albertvaka/MHI-WifiController/presentation_cat.pdf

# Enginyeria inversa d'un aparell d'aire condicionat per connectar-lo al WiFi

Albert Vaca Cintora <albertvaka@gmail.com>

Projecte original: Albert Vaca Cintora, Joan Montserrat, Marce Coll

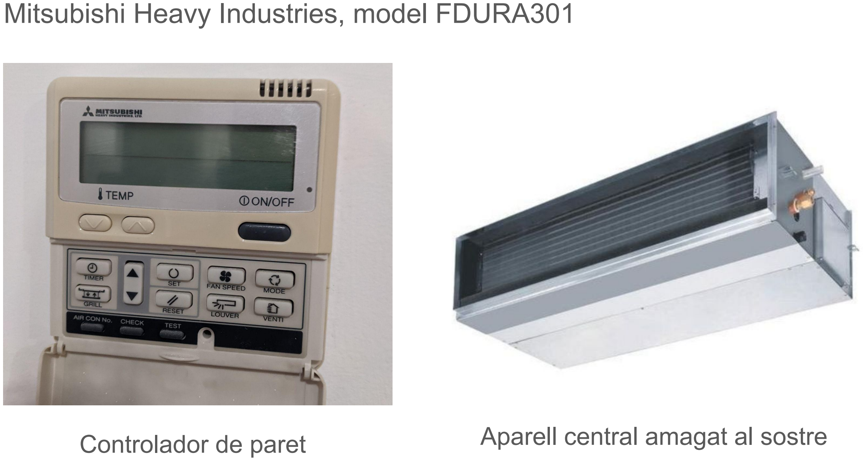
[picture p1: page 2]

Aparell central amagat al sostre

Controlador de paret

Mitsubishi Heavy Industries, model FDURA301

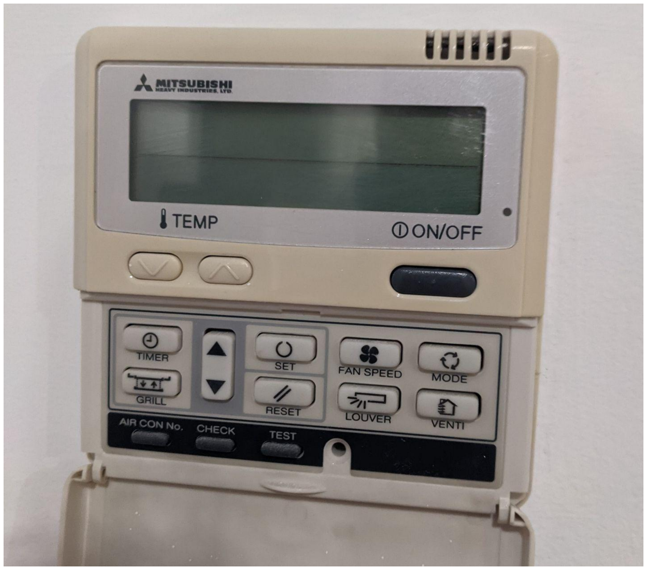
[picture p2: figure]

Per canviar la temperatura m'he d'aixecar del sofà.

L'única automatització possible és configurar l'hora d'encendre/apagar.

Podem fer-ho millor…

Mitsubishi Heavy Industries, model FDURA301

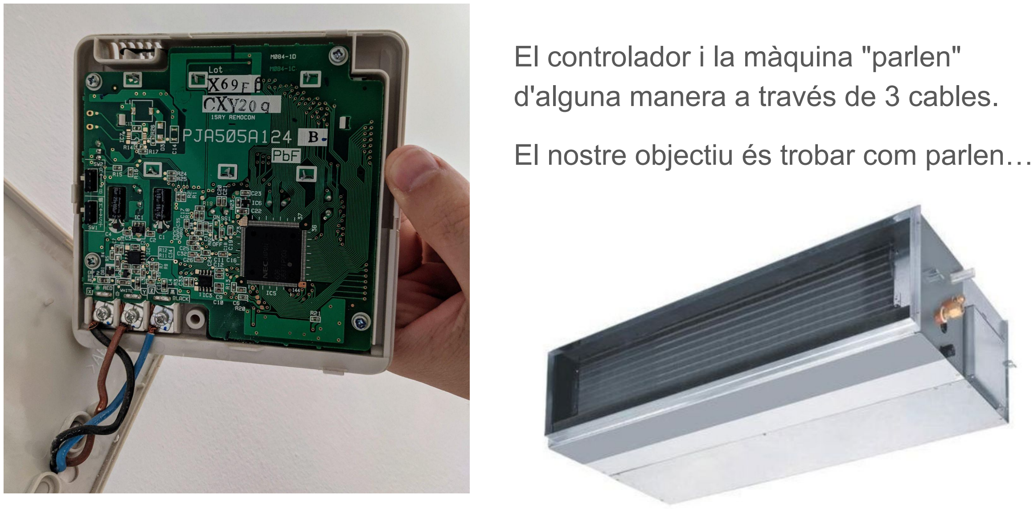
[picture p3: page 4]

El controlador i la màquina "parlen" d'alguna manera a través de 3 cables.

El nostre objectiu és trobar com parlen…

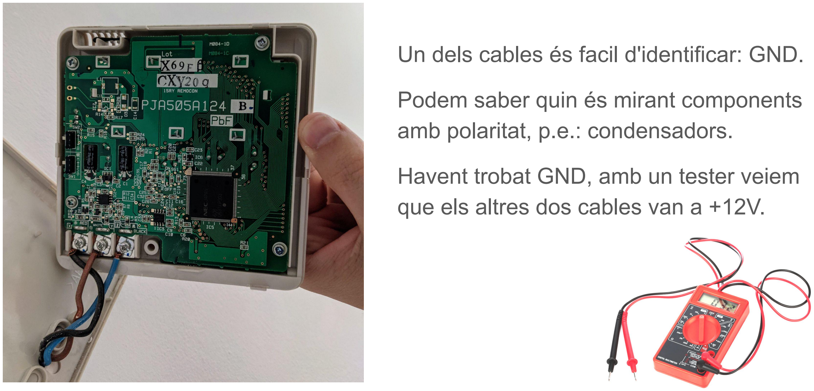
[picture p4: page 5]

Un dels cables és facil d'identificar: GND.

Podem saber quin és mirant components amb polaritat, p.e.: condensadors.

Havent trobat GND, amb un tester veiem que els altres dos cables van a +12V.

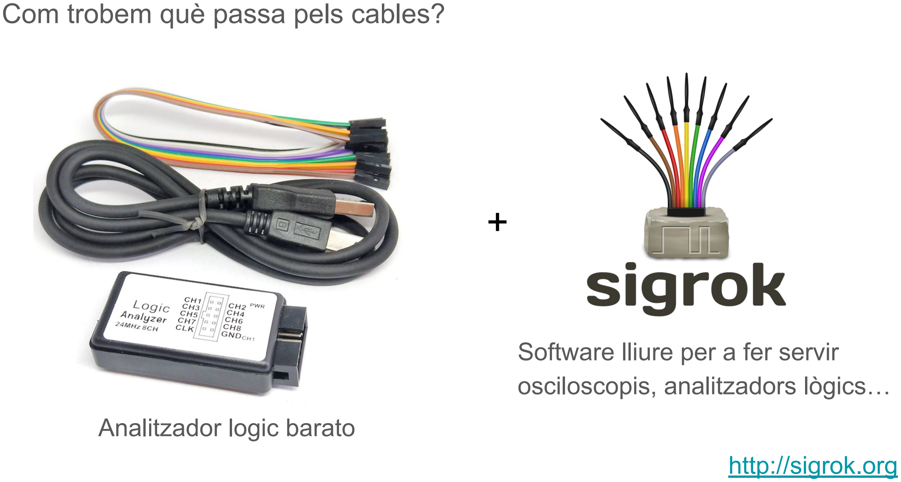
[picture p5: page 6]

Analitzador logic barato

+

Com trobem què passa pels cables?

Software lliure per a fer servir osciloscopis, analitzadors lògics…

http://sigrok.org

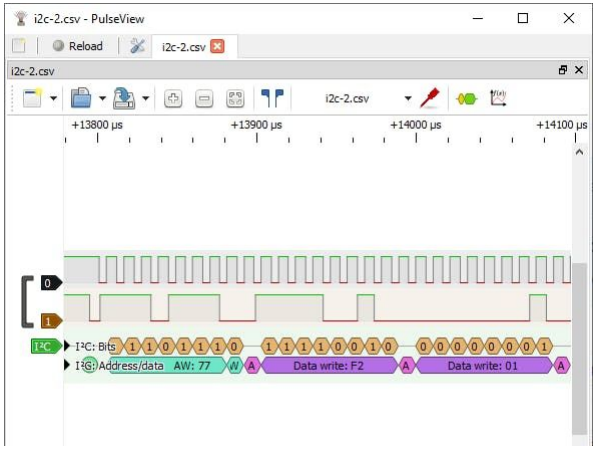
[picture p6: figure]

PulseView, la interfície gràfica de Sigrok

Oju! No podem connectar directament 12V a l'analitzador

El fregiríem.

Oju! No podem connectar directament 12V a l'analitzador

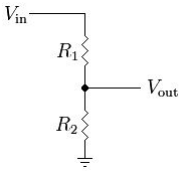
[picture p7: figure]

Esquema i fòrmula d'un
divisor de tensió.

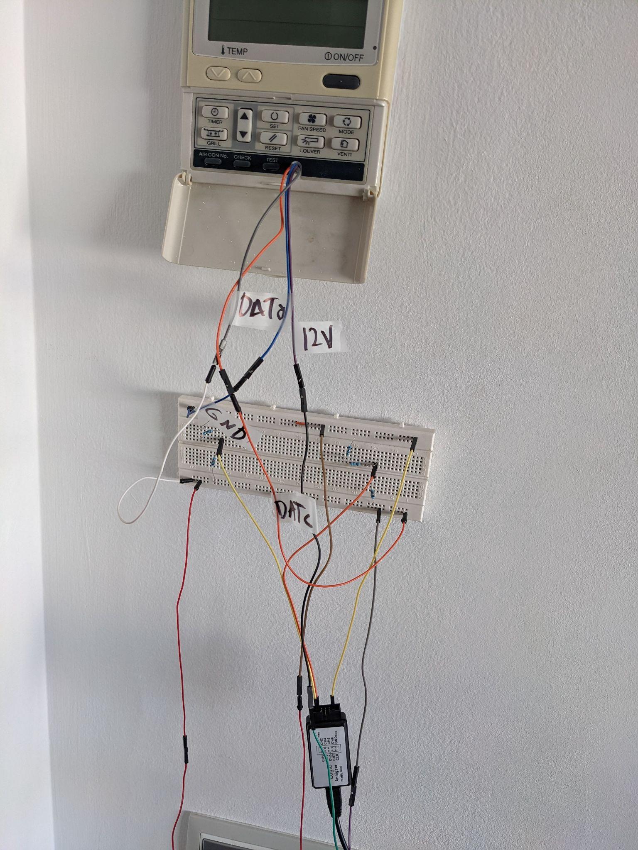
[picture p8: figure]

Dos divisors de tensió entre els dos cables de 12V i l'analitzador.

Els divisors de tensió passen de 12V a ~3V.

El GND també el connectem a l'analitzador, és la referència.

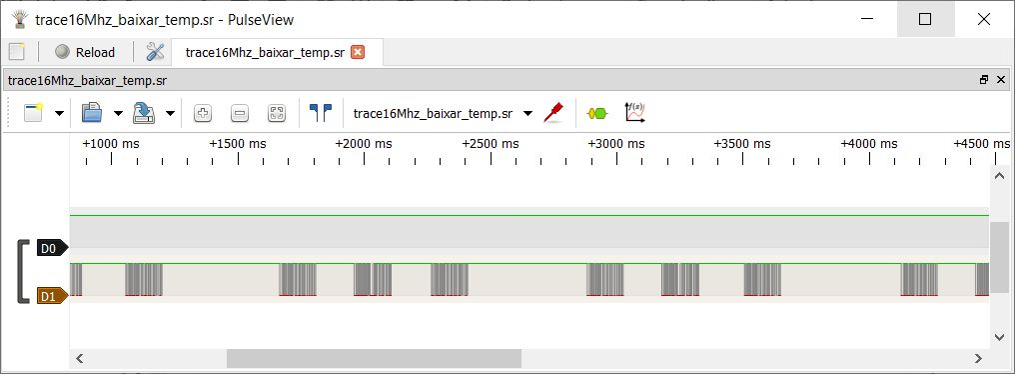
[picture p9: figure]

Veiem cosetes i fem els primers descobriments.

Un dels dos cables de +12V és simplement corrent, no té dades.

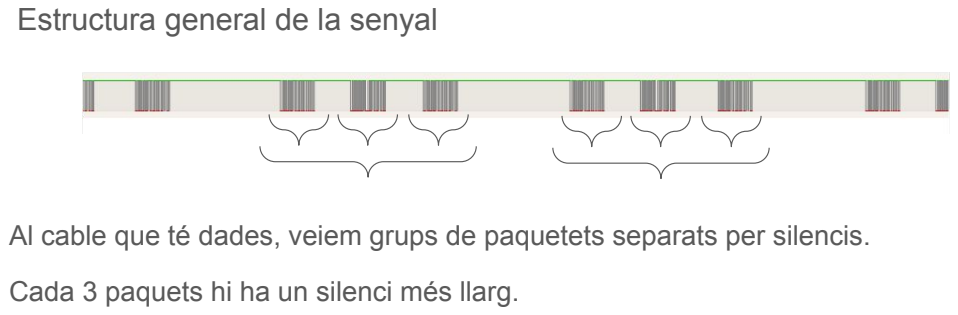
[picture p10: page 13]

Estructura general de la senyal

Al cable que té dades, veiem grups de paquetets separats per silencis.

Cada 3 paquets hi ha un silenci més llarg.

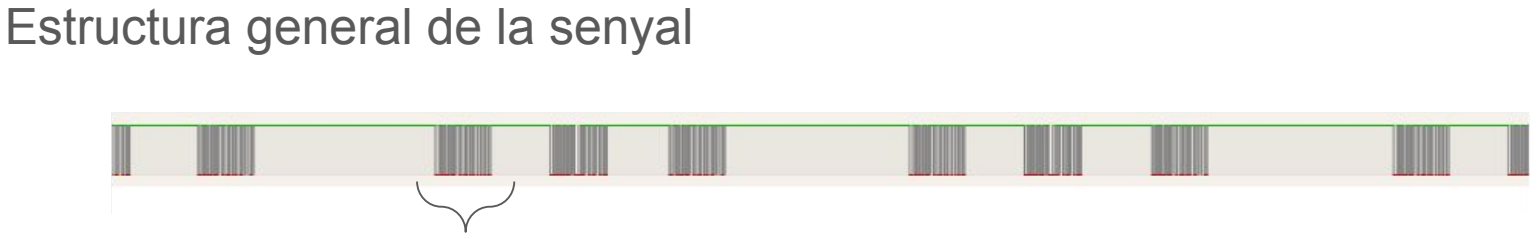
[picture p11: figure]
Estructura general de la senyal

Si fem zoom a un dels paquets, veiem que la senyal és binaria.

S'envien dades tota l'estona, encara que no faci cap canvi al controlador.

També amb l'aire apagat: la senyal d'on/off és digital.

Només hi ha un cable de dades -> la comunicació és unidireccional (??)

Estructura general de la senyal

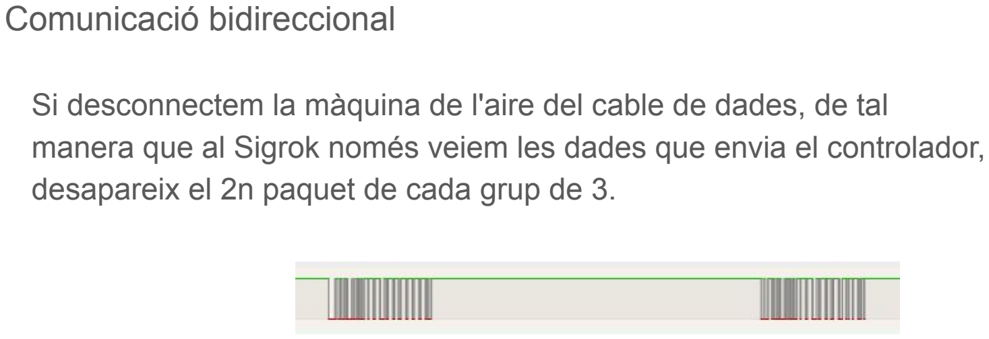
[picture p12: figure]
Comunicació bidireccional

Si desconnectem la màquina de l'aire del cable de dades, de tal manera que al Sigrok només veiem les dades que envia el controlador, desapareix el 2n paquet de cada grup de 3.

Si connectem la màquina però desconnectem el controlador, desapareixen el 1r i el 3r paquets!

Comunicació bidireccional

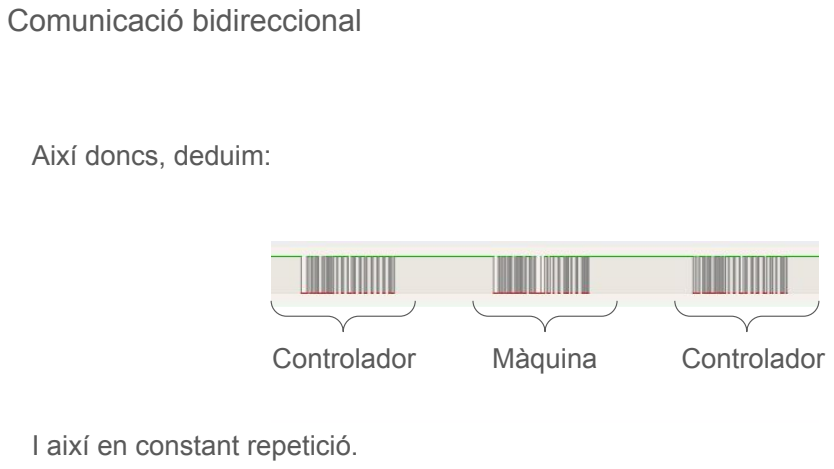
[picture p13: page 18]
Controlador; Màquina; Comunicació bidireccional

Així doncs, deduim:

I així en constant repetició.

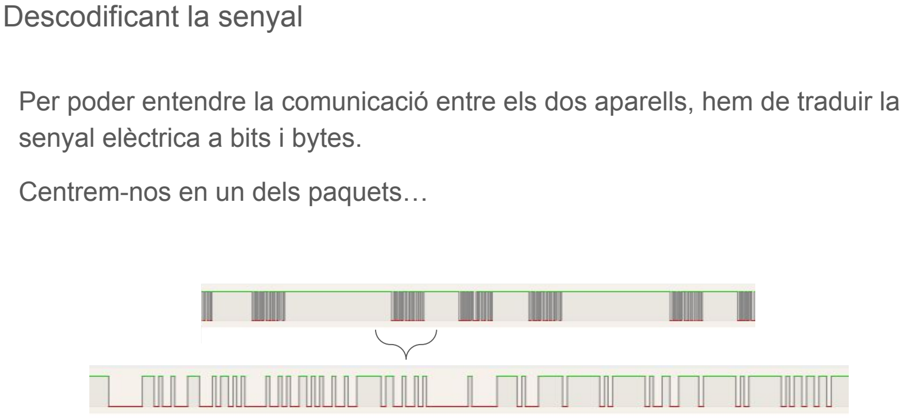
[picture p14: figure]
senyal elèctrica a bits i bytes.; Centrem-nos en un dels paquets…; Descodificant la senyal

Per poder entendre la comunicació entre els dos aparells, hem de traduir la

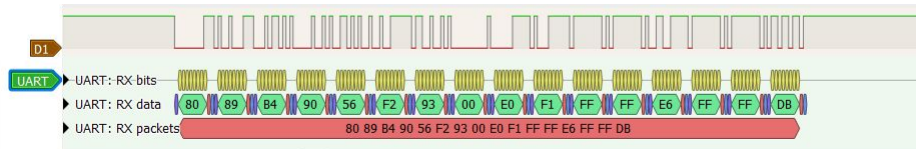
[picture p15: figure]

Tenim sort i el Sigrok sap descodificar el protocol que fan servir:

- UART a 1200 bauds
- Amb bit de paritat senar cada 8 bits
- Agrupats en paquets de 16 bytes

Descodificant la senyal

Així podem descodificar cadascún dels paquets:

Descodificant la senyal

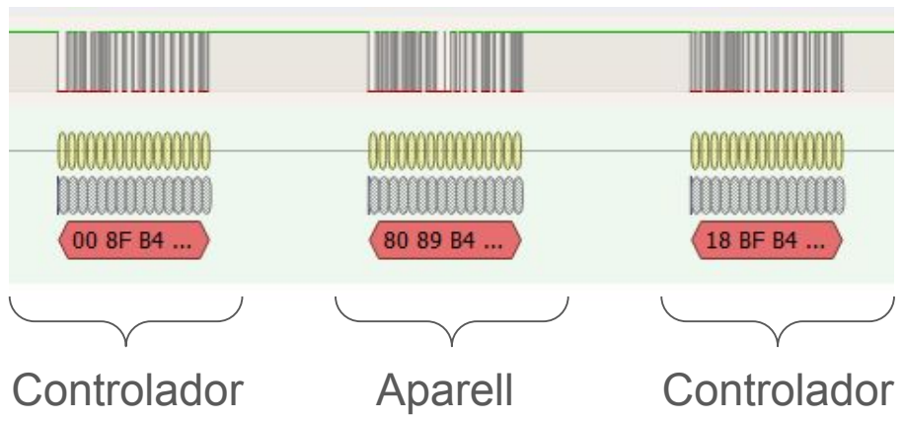
[picture p16: figure]
Controlador; Aparell

Agafem-ne una mostra en format hexadecimal i anem a un editor de text!

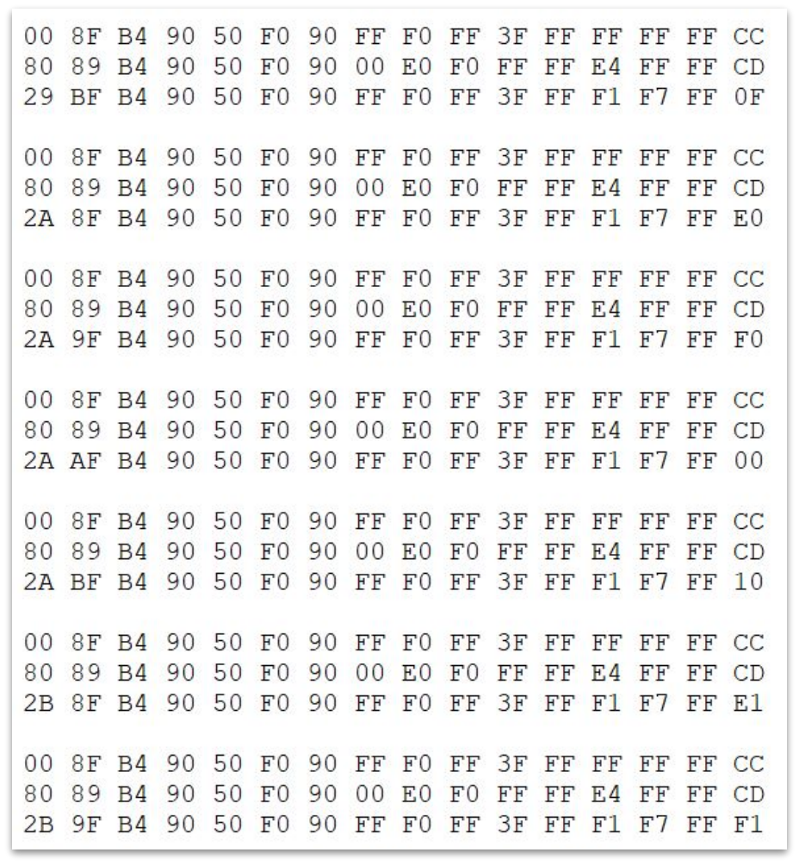
[picture p17: figure]

Si descodifiquem uns quants grups de 3 paquets, veiem que entre un grup i el següent hi ha pocs canvis.

Si descodifiquem uns quants grups de 3 paquets, veiem que entre un grup i el següent hi ha pocs canvis.

Els primers 2 bytes de cada 3r paquet canvien en seqüencia ascendent, segurament són una ID.

Si descodifiquem uns quants grups de 3 paquets, veiem que entre un grup i el següent hi ha pocs canvis.

Els primers 2 bytes de cada 3r paquet canvien en seqüencia ascendent, segurament són una ID.

L'ultim byte té molta més entropia que la resta, segurament és un checksum.

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

Els primers 2 bytes de cada 3r paquet canvien en seqüencia ascendent, segurament són una ID.

L'ultim byte té molta més entropia que la resta, segurament és un checksum.

- En efecte, fent servir eines online que calculen els checksums més comuns veiem que és una suma de bytes módul 256.

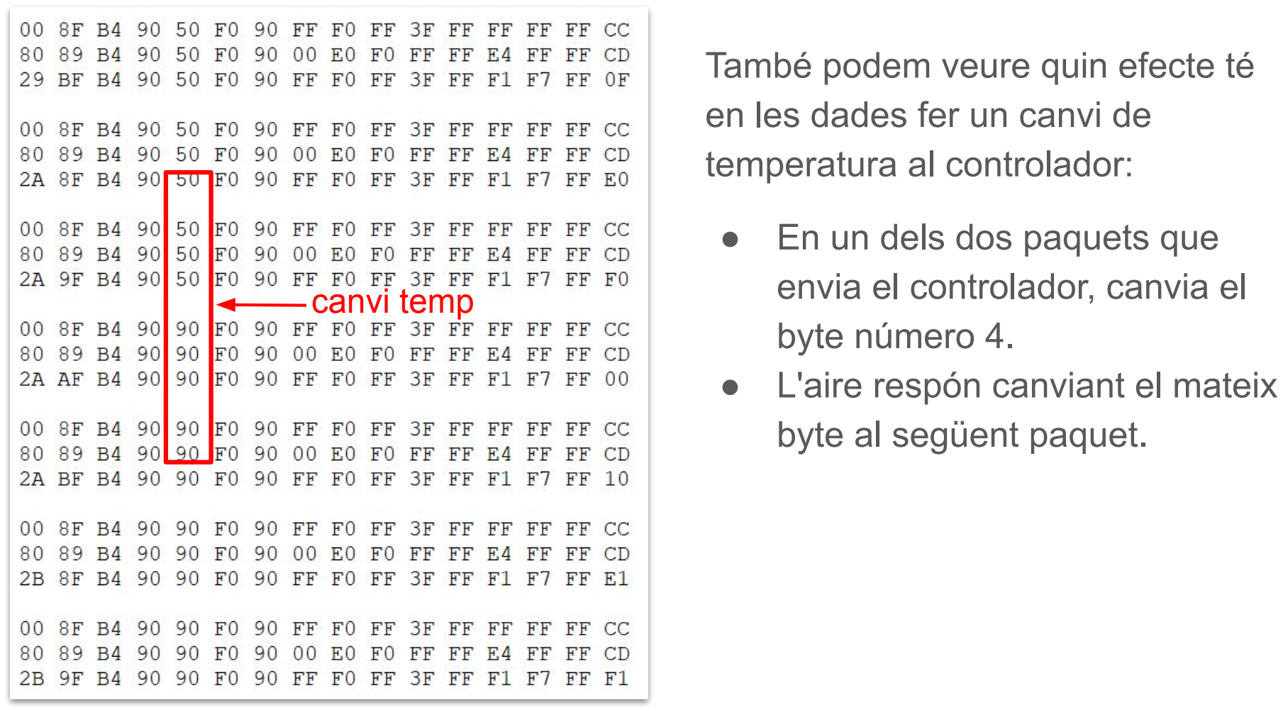
[picture p18: page 27]

També podem veure quin efecte té en les dades fer un canvi de temperatura al controlador:

- En un dels dos paquets que envia el controlador, canvia el byte número 4.
- L'aire respón canviant el mateix byte al següent paquet.

canvi temp

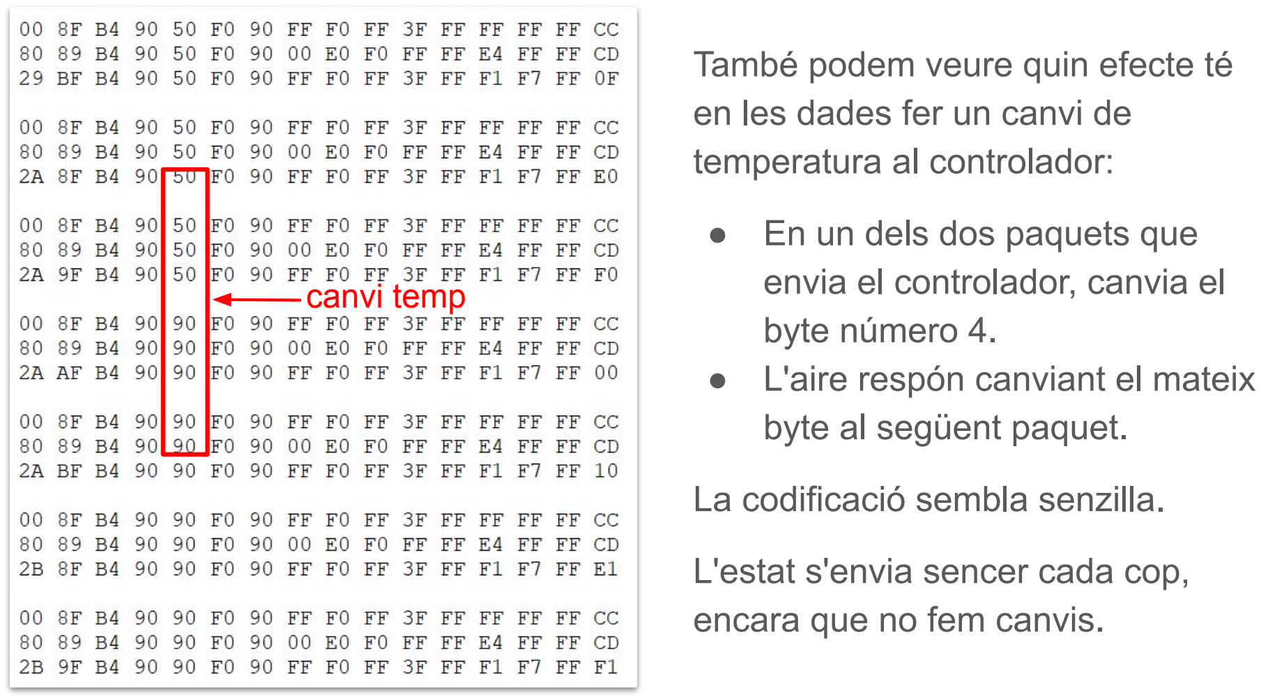
[picture p19: page 28]

També podem veure quin efecte té en les dades fer un canvi de temperatura al controlador:

- En un dels dos paquets que envia el controlador, canvia el byte número 4.
- L'aire respón canviant el mateix byte al següent paquet.

La codificació sembla senzilla.

L'estat s'envia sencer cada cop, encara que no fem canvis.

canvi temp

El Person-in-the-Middle

Si aconseguim modificar aquest estat que el controlador envia, podem donar ordres a la màquina de l'aire.

El Person-in-the-Middle

Si aconseguim modificar aquest estat que el controlador envia, podem donar ordres a la màquina de l'aire.

Si aprofitem que l'estat s'envia constantment i el modifiquem, ens estalviem"inventar" paquets des de zero: partim d'un paquet valid.

- Ens estalviem d'entendre el 100% del paquet, generar les IDs, etc.
- Podem mantenir el controlador de paret i no substituir-lo.

El Person-in-the-Middle

Si aconseguim modificar aquest estat que el controlador envia, podem donar ordres a la màquina de l'aire.

Si aprofitem que l'estat s'envia constantment i el modifiquem, ens estalviem"inventar" paquets des de zero: partim d'un paquet valid.

- Ens estalviem d'entendre el 100% del paquet, generar les IDs, etc.
- Podem mantenir el controlador de paret i no substituir-lo.

El Person-in-the-Middle

Per poder modificar els paquets necessitem intervenir la comunicació.

El Person-in-the-Middle

Per poder modificar els paquets necessitem intervenir la comunicació.

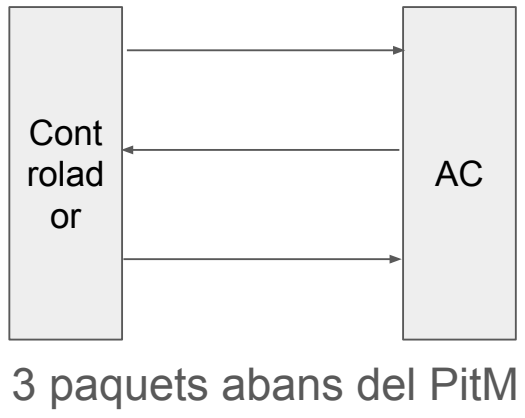
[picture p20: figure]
3 paquets abans del PitM; Cont rolad or

El Person-in-the-Middle

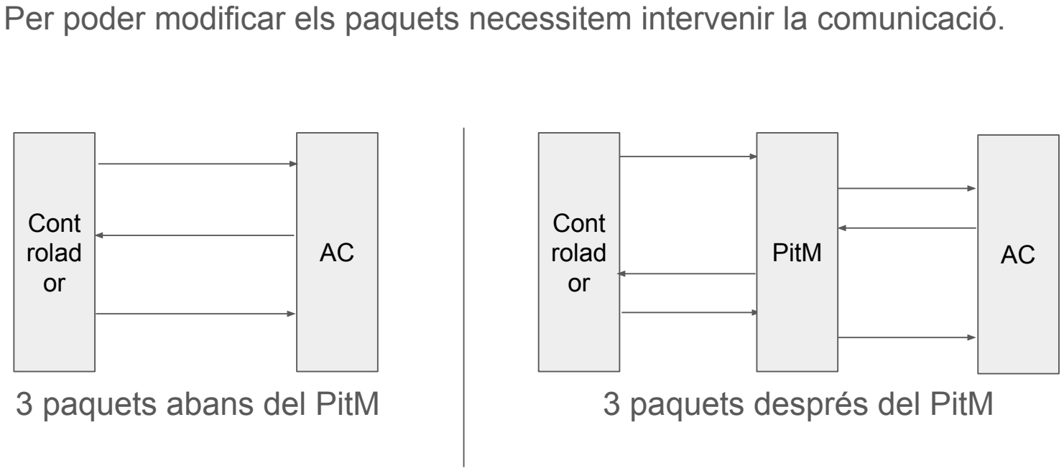
[picture p21: figure]
3 paquets després del PitM; Cont rolad or; PitM; 3 paquets abans del PitM

Per poder modificar els paquets necessitem intervenir la comunicació.

L'Arduino

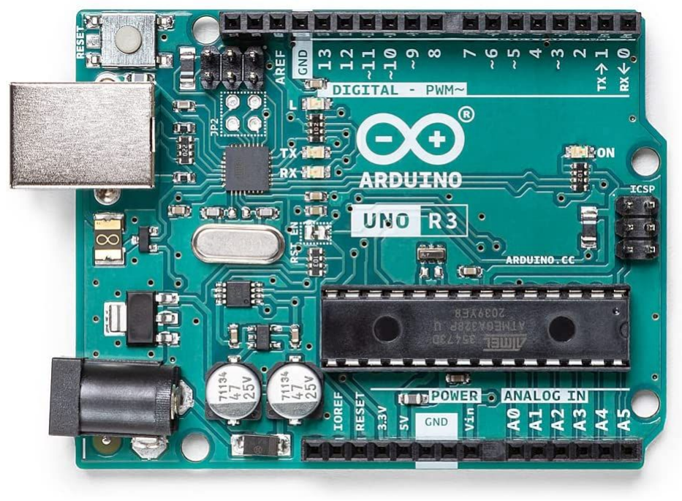
[picture p22: figure]

Projecte de software lliure i hardware lliure.

Fa molt fàcil la interacció entre electrònica i software.

http://ardunio.cc

Problemes de nou amb els 12V

L'arduino "parla" a 5V i no 12V.

El divisor de tensió no és suficient: Necessitem reduir de 12V a 5V per a poder llegir la senyal, però també apujar-la de 5V a 12V quan la enviem.

El "bidirectional logic level converter"

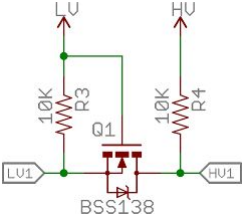
[picture p23: figure]

Internet opina que aquest circuit amb un transistor mosfet i dues resistències fa el que volem.

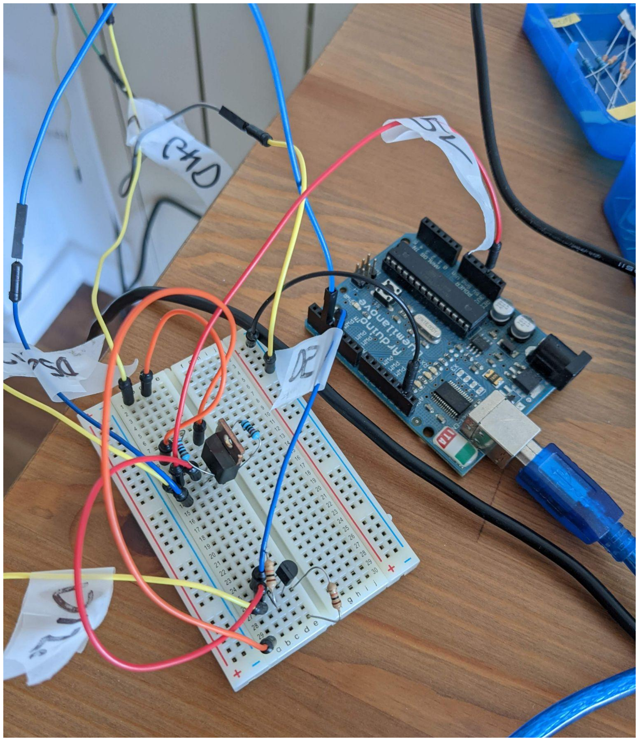
[picture p24: figure]

Arduino i amb dos "bidirectional logic level converters".

Per una banda, connectat a l'aparell de l'aire. Per l'altra, al controlador.

Ja no hi ha un cable de dades directe entre el controlador i la maquina d'aire.

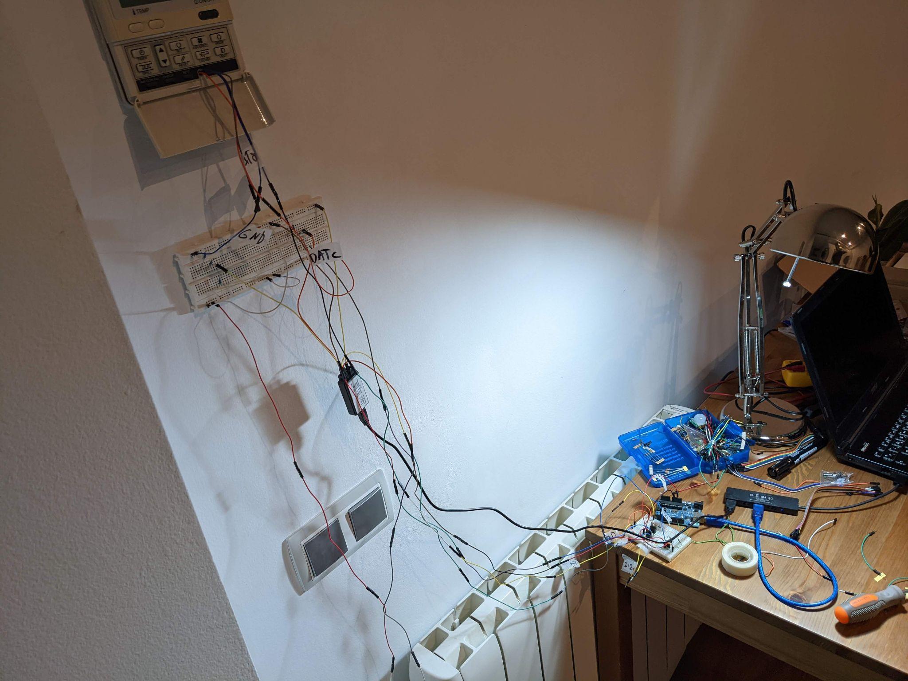
[picture p25: page 39]

Primer objectiu: passar les dades a través nostre i que la màquina i el controlador no s'adonin que som al mig.

A programar

Cont
rolad
or
PitM | AC

Primer objectiu: passar les dades a través nostre i que la màquina i el controlador no s'adonin que som al mig.

Hi ha llibreries d'Arduino per a UART, però no ens seveixen:

- Et fan llegir tot un byte abans de poder-lo escriure
- El delay fa enfadar la maquina d'aire

Cal llegir bit a bit per una banda i escriure'l immediatament per l'altra.

A programar

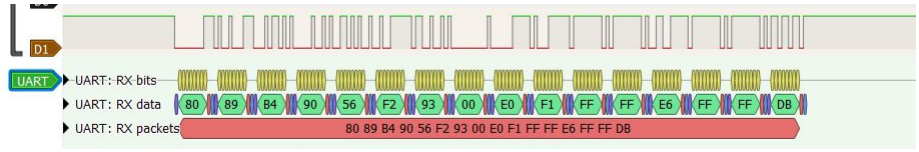
[picture p26: figure]

Primer objectiu: passar les dades a través nostre i que la màquina i el controlador no s'adonin que som al mig.

Hi ha llibreries d'Arduino per a UART, però no ens seveixen:

- Et fan llegir tot un byte abans de poder-lo escriure
- El delay fa enfadar la maquina d'aire

Cal llegir bit a bit per una banda i escriure'l immediatament per l'altra.

~200 linies de codi, i l'aire torna a funcionar!

A programar

https://github.com/albertvaka/MHI-WifiController/blob/69b3c11de/MHI-WifiController.ino

Segon objectiu: modificar l'estat que passa a través nostre.

El bit d'on/off és senzill de trobar i fàcil comprovar si ha canviat.

A programar

Segon objectiu: modificar l'estat que passa a través nostre.

El bit d'on/off és senzill de trobar i fàcil comprovar si ha canviat.

Però ens cal recalcular els parity bits i el checksum!

A programar

Segon objectiu: modificar l'estat que passa a través nostre.

El bit d'on/off és senzill de trobar i fàcil comprovar si ha canviat.

Però ens cal recalcular els parity bits i el checksum!

~260 linies de codi

A programar

https://github.com/albertvaka/MHI-WifiController/blob/e3155bb0c/MHI-WifiController.ino

Tercer objectiu: trobar com es representa la resta de l'estat i poder modificar-lo.

A programar

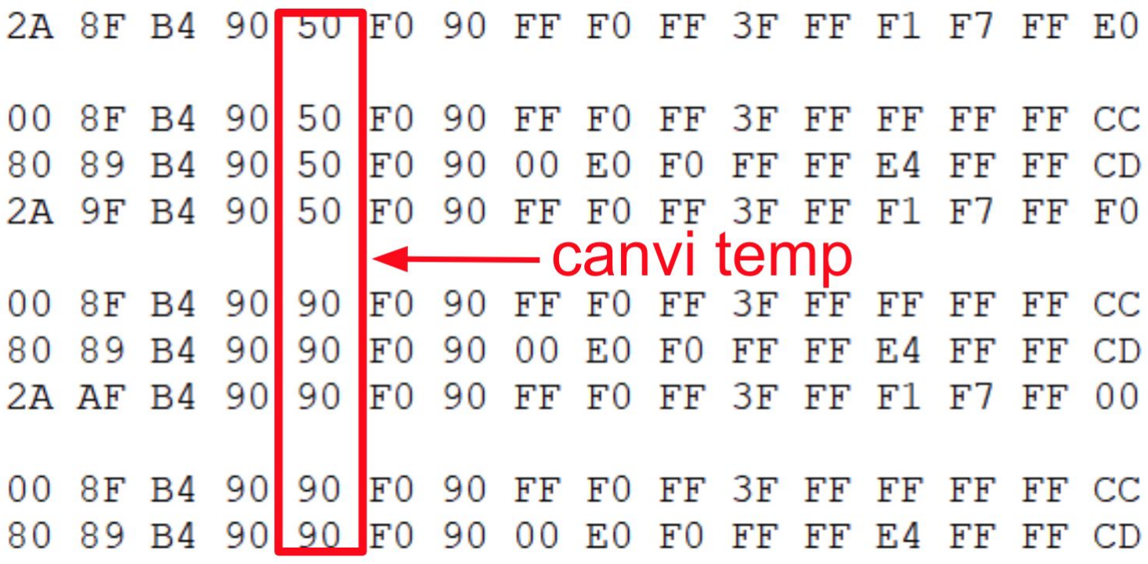
[picture p27: figure]

Tercer objectiu: trobar com es representa la resta de l'estat i poder modificar-lo.

Alguns valors són fàcils: velocitat del ventilador, mode, etc.

Hi ha dues temperatures: la desitjada i la actual. Codificades diferent!

A programar

Tercer objectiu: trobar com es representa la resta de l'estat i poder modificar-lo.

Alguns valors són fàcils: velocitat del ventilador, mode, etc.

Hi ha dues temperatures: la desitjada i la actual. Codificades diferent!

- La temperatura desitjada la podem canviar al valor que vulguem

A programar

Tercer objectiu: trobar com es representa la resta de l'estat i poder modificar-lo.

Alguns valors són fàcils: velocitat del ventilador, mode, etc.

Hi ha dues temperatures: la desitjada i la actual. Codificades diferent!

- La temperatura desitjada la podem canviar al valor que vulguem

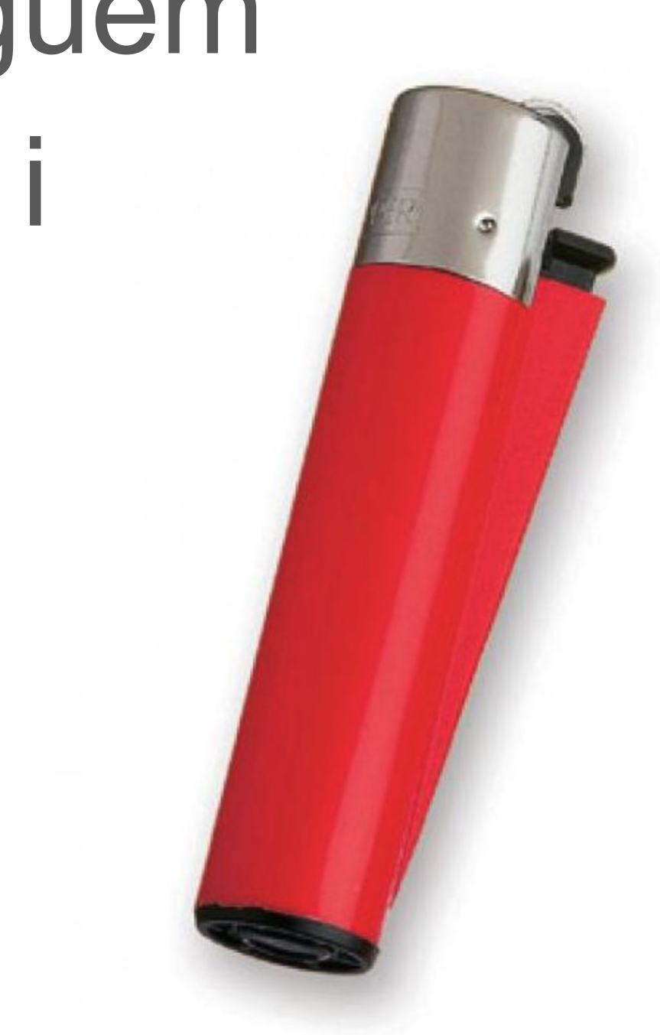
[picture p28: figure]

- La temperatura actual la podem canviar amb un encenedor i mirar el valor.

A programar

Descodificant la temperatura

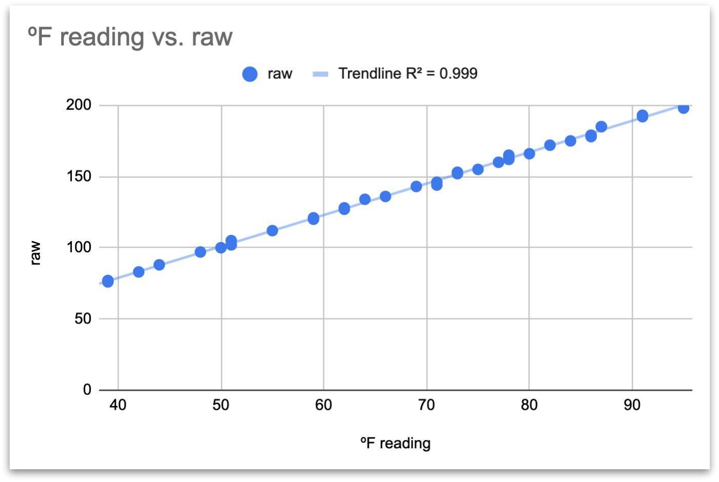
[picture p29: figure]

El controlador no mostra els decimals de la temperatura…Si configurem Fahrenheit tenim salts més petits :)

Resultat:

F = (0.4527 * raw) + 4.353

Amb alguns punts i una regressió lineal podem trobar la fòrmula.

Descodificant la temperatura

F = (0.4527 * raw) + 4.353

És una merda de fòrmula. Algú ha programat això?

Descodificant la temperatura

F = (0.4527 * raw) + 4.353

És una merda de fòrmula. Algú ha programat això?

Passem a Celsius:

C = (0.2515 * raw) - 15.3594

Descodificant la temperatura

F = (0.4527 * raw) + 4.353

És una merda de fòrmula. Algú ha programat això?

Passem a Celsius:

C = (0.2515 * raw) - 15.3594

Ep! Això s'assembla molt a:

C = (0.25 * raw) - 15

Descodificant la temperatura

F = (0.4527 * raw) + 4.353

És una merda de fòrmula. Algú ha programat això?

Passem a Celsius:

C = (0.2515 * raw) - 15.3594

Ep! Això s'assembla molt a:

C = (0.25 * raw) - 15

És molt més raonable que algú hagi programat això!

- Increments de quarts de grau, a partir de -15 graus.

Ja podem llegir i escriure qualsevol part de l'estat!

~350 linies de codi

A programar

https://github.com/albertvaka/MHI-WifiController/blob/c4098a604/MHI-WifiController.ino

Quart objectiu: connectar-ho a internet.

A programar

Quart objectiu: connectar-ho a internet.

Passem d'Arduino a ESP8266 que té WiFi incorporat.

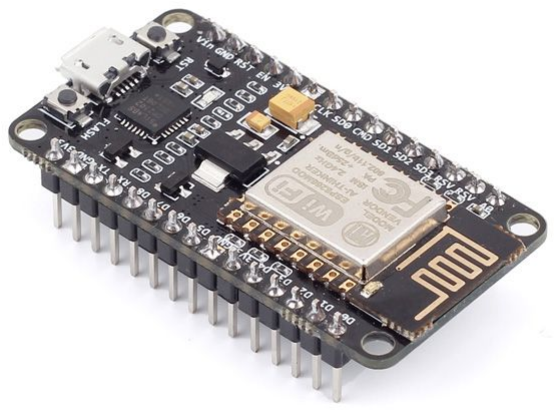
[picture p30: figure]

Pero no és HW lliure :(

A programar

Quart objectiu: connectar-ho a internet.

Passem d'Arduino a ESP8266 que té WiFi incorporat.

Per a interactuar-hi des del mòbil amb una app o via Google Home/Alexa/Siri, hi ha diferents serveis i APIs.

Tampoc son lliures :(

~650 lines de codi

A programar

Prototip funcionant

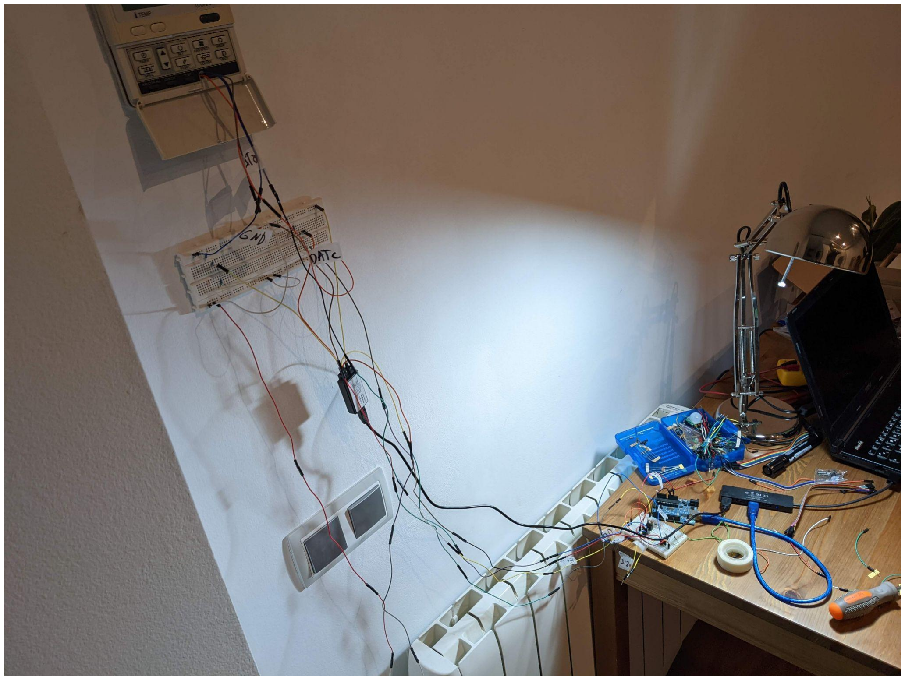
[picture p31: figure]

Pero tenir cables penjant al menjador no mola

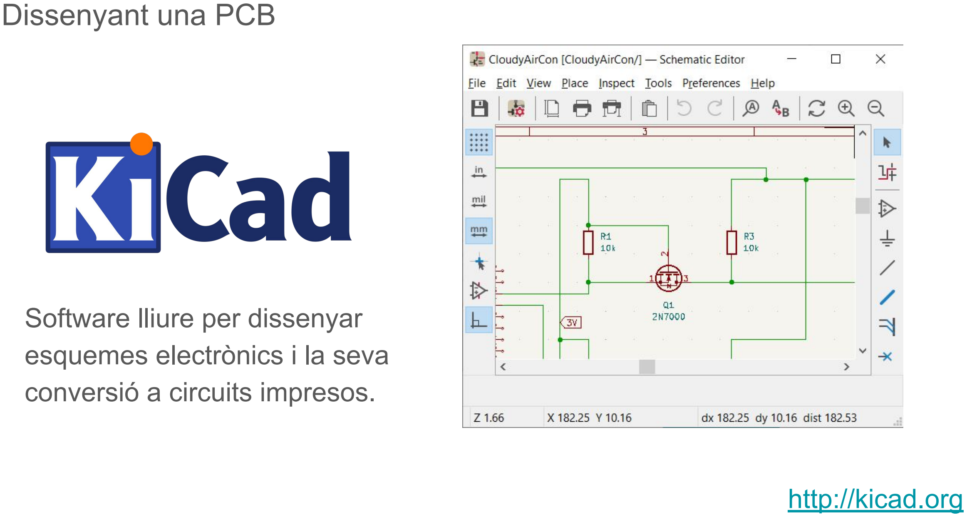
[picture p32: page 60]

Dissenyant una PCB

http://kicad.org (http://sigrok.org)

Software lliure per dissenyar esquemes electrònics i la seva conversió a circuits impresos.

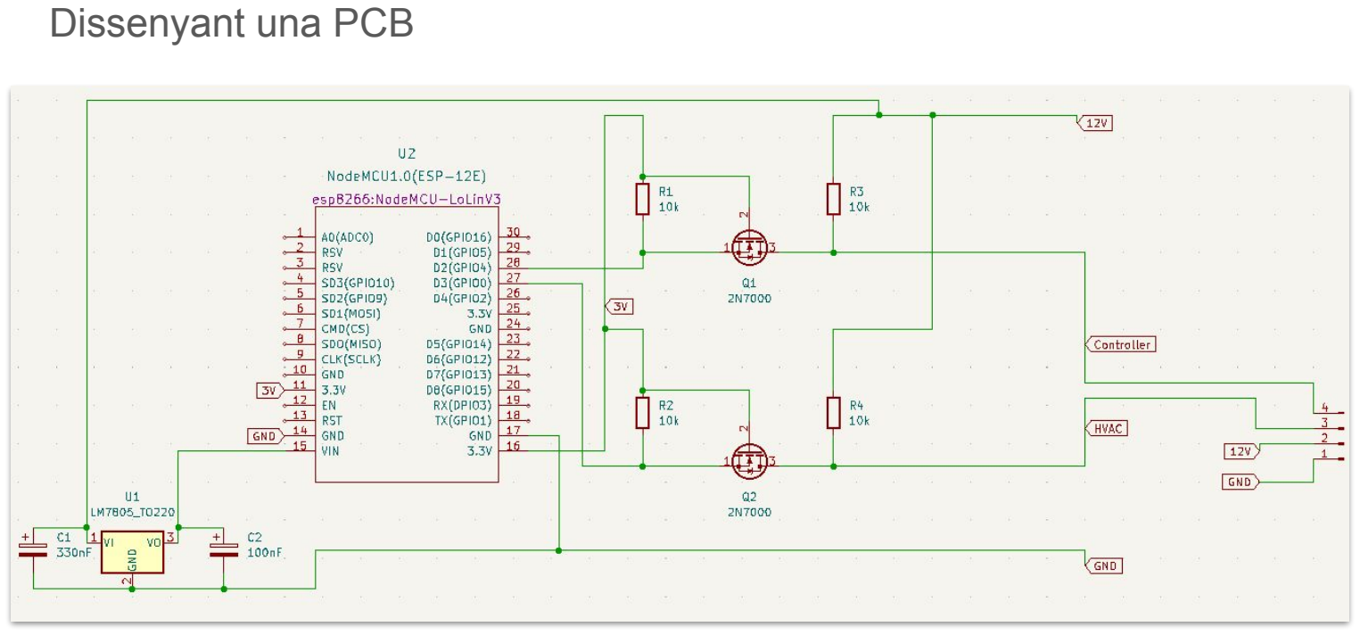
[picture p33: page 61]

Dissenyant una PCB

Dissenyant una PCB

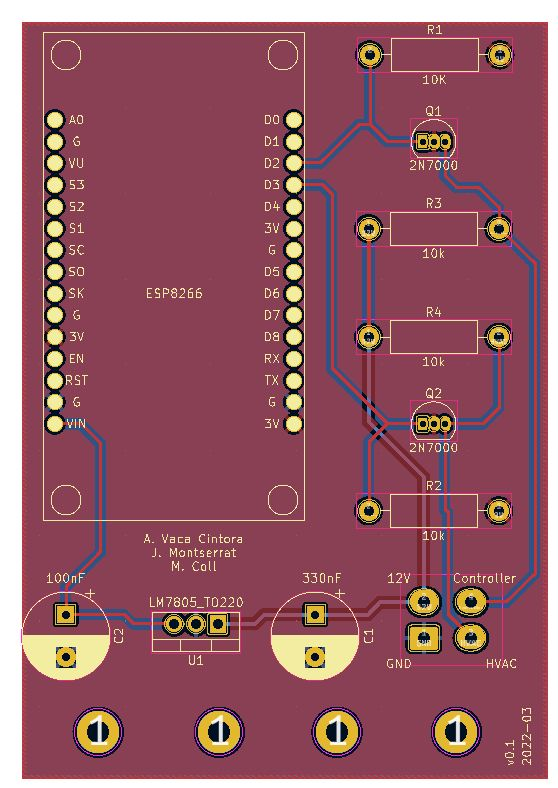
[picture p34: figure]

Un cop dissenyada, KiCad
permet exportar en format
Gerber per enviar a fabricar.

Costa ~10€ fabricar 5 PCBs.

Cal comprar els components per separat i i soldar-los.

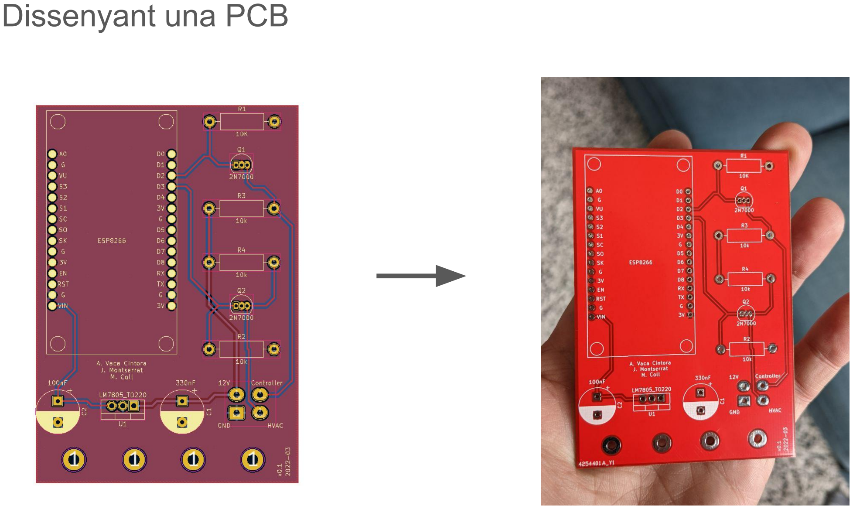
[picture p35: page 63]

Dissenyant una PCB

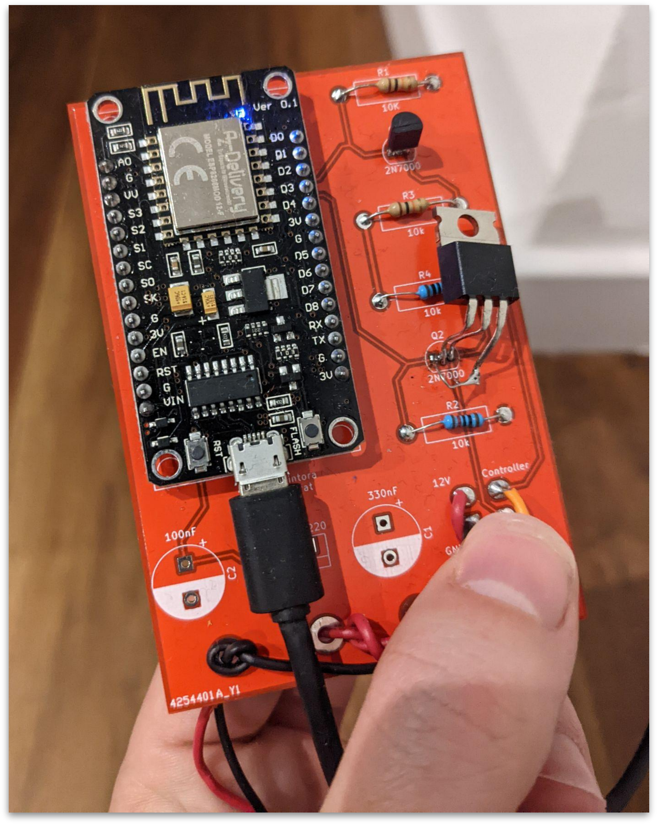
[picture p36: figure]

El resultat final

- Encendre/apagar l'aire i canviar la temperatura des del mòbil
- També per veu amb Google Home
- Històric de la temperatura de casa
- Puc programar canvis de
temperatura quan es pon el sol, quan sona el despertador, etc.

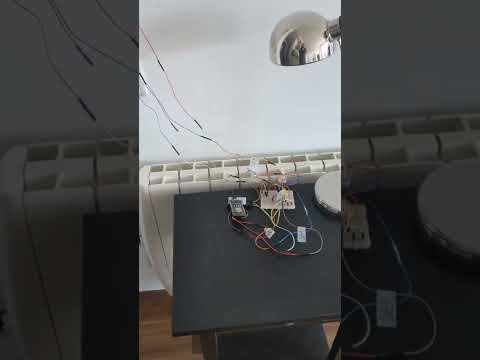
[picture p37: page 65]
