albertvaka/MHI-WifiController/(threads)

Thread 1 (2025-01-07):

commands when off?

lonione, 2025-01-07:
hi albertvaka!
i just discovered this code, and it looks like it could potentially solve something i'm trying to achieve  = controlling an old MHI A/C remotely (in my case circa 2008 SRRM-ZF indoor units, which use the same 3-wire RC as yours.) I'm hoping it uses the same protocol as you reversed, or if not I can use your knowledge to progress...

just by reading your description, i'm just not sure how does it work in reality?
if you can't "create" new messages on the data wire, how do you send new commands?if by changing existing packets, does the RC communicate with the AC unit periodically even if no buttons are pressed? what if it's off - can you turn on remotely?

I'm happy to post my results when I get around to testing it (in approx 2 months)

Thanks for your work and making it opensource!

albertvaka, 2025-01-07:
Yes, they communicate every half a second or so continuously. I don't know how to create a packet from scratch, so I just modify on the fly the packets that are being sent. I've uploaded a PDF to this repo with the slides of a presentation I did (in Catalan), so maybe you can understand a bit more my findings and also make sure we have a similar device.
