albertvaka/MHI-WifiController/(commit log)

2022-03-09 Print each controller state via serial
2022-03-09 Allow changing the mode, fan speed and setpoint
    Reset our state if changes to the controller state are detected
    [MHI-WifiController.ino]
2022-03-09 Parse and print the room temperature received from the IU
2022-03-11 Cleanup/formating changes and blink builtin led
